purduerov/X12-Solenoid-Board/solenoid.step

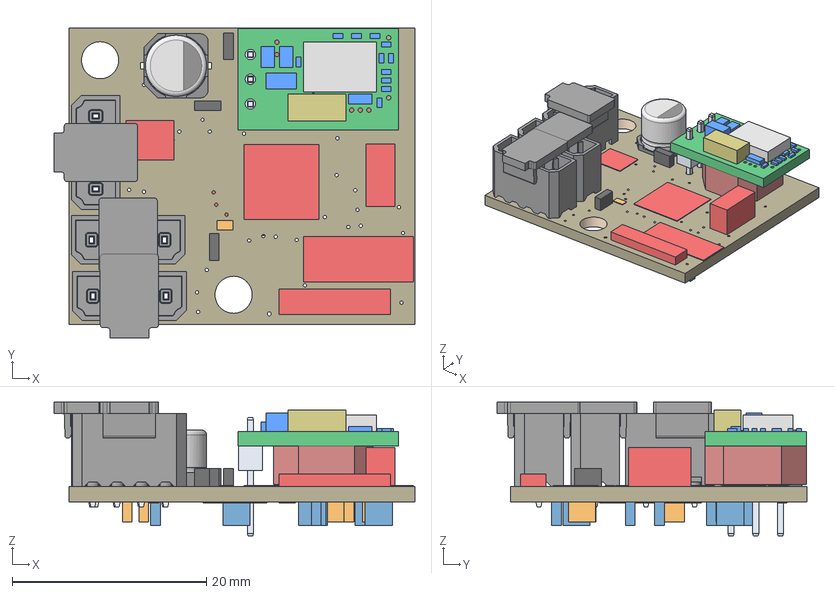
[picture p1: CAD file, 2020-10-26]
solenoid.step
37.1 x 31.9 x 13.8 mm
Board
20pF x 7
0.1uF
LED-0603 x 3
FE05-1
STM32F042K6T6
ECS-80-S-4X
MURATA-DC-DC
ULN2003V12
DISCRETECOMPONENTS_SWITCH
6-32-HOLE x 2
ptsm_0.5_pad x 3
ptsm_0.5-4-hv-2.5-thr x 3
TCAN337D
WSIZE CODE D-001
WSIZE CODE D-002
WSIZE CODE D-003 x 2
