purduerov/X12-Solenoid-Board/solenoid.brd

## EAGLE design solenoid.brd (2020-10-26)

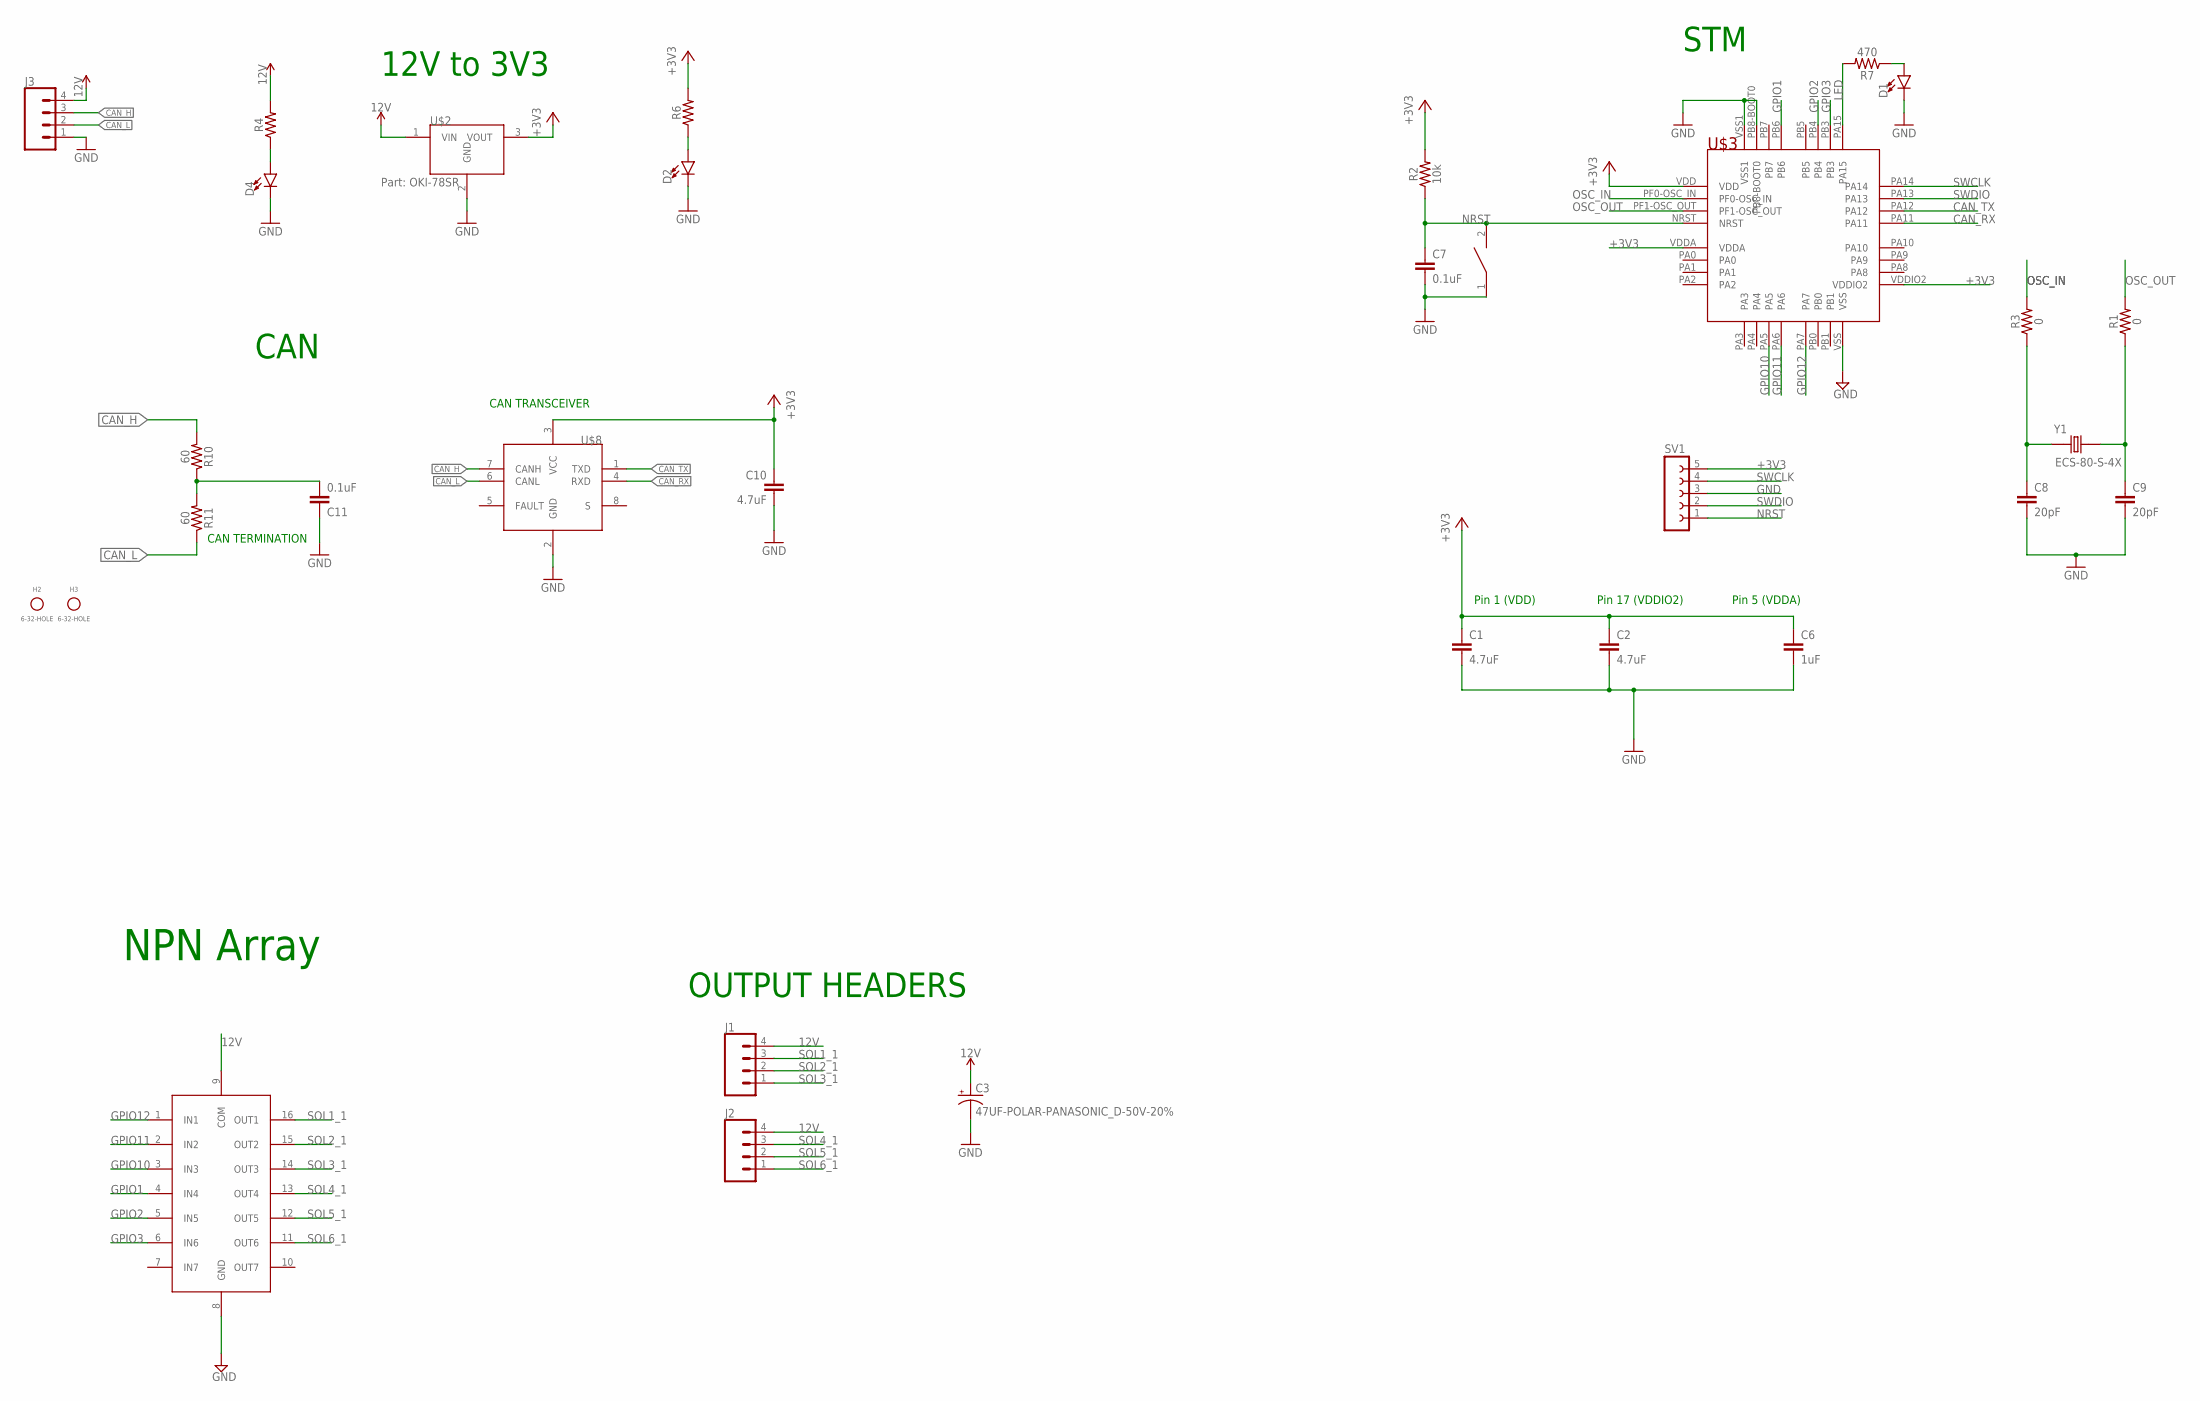
[picture p2: schematic solenoid.sch]

Parts:
C1, C2, C10: 4.7uF; 0603
C3: 47UF-POLAR-PANASONIC_D-50V-20%; PANASONIC_D
C6: 1uF; 0603
C7, C11: 0.1uF; 0603
C8, C9: 20pF; 0603
D1, D2, D4: LED0603; LED-0603
H2, H3: 6-32-HOLE
J1, J2, J3: PXC-PTSM-04-V-1778573
R1, R3: 0; 0603
R2: 10k; 0603
R4, R6: 0603
R7: 470; 0603
R10, R11: 60; 0603
SV1: FE05-1
U1: ULN2003V12
U$1: DISCRETECOMPONENTS_SWITCH; DISCRETECOMPONENTS_SW_2512
U$2: MURATA-DC-DC
U$3: STM32F042K6T6
U$8: TCAN337D; SOIC-8
Y1: ECS-80-S-4X; XTAL_ECS-80-S-4X

Connections:
12V: C3.+, J1.4, J2.4, J3.4, R4.2, U1.9 (COM), U$2.1 (VIN)
+3V3: C1.1, C2.1, C6.1, C10.1, R2.2, R6.2, SV1.5, U$2.3 (VOUT), U$3.VDD, U$3.VDDA, U$3.VDDIO2, U$8.3 (VCC)
CAN_H: J3.3, R10.2, U$8.7 (CANH)
CAN_L: J3.2, R11.1, U$8.6 (CANL)
CAN_RX: U$3.PA11, U$8.4 (RXD)
CAN_TX: U$3.PA12, U$8.1 (TXD)
GND: C1.2, C2.2, C3.-, C6.2, C7.2, C8.2, C9.2, C10.2, C11.1, D1.C, D2.C, D4.C, J3.1, SV1.3, U1.8 (GND), U$1.1, U$2.2 (GND), U$3.PB8-BOOT0, U$3.VSS, U$3.VSS1, U$8.2 (GND)
GPIO1: U1.4 (IN4), U$3.PB6
GPIO2: U1.5 (IN5), U$3.PB4
GPIO3: U1.6 (IN6), U$3.PB3
GPIO10: U1.3 (IN3), U$3.PA5
GPIO11: U1.2 (IN2), U$3.PA6
GPIO12: U1.1 (IN1), U$3.PA7
LED: R7.2, U$3.PA15
unnamed: C9.1, R1.1, Y1.2
unnamed: C8.1, R3.1, Y1.1
unnamed: C11.2, R10.1, R11.2
unnamed: D1.A, R7.1
unnamed: D4.A, R4.1
unnamed: D2.A, R6.1
NRST: C7.1, R2.1, SV1.1, U$1.2, U$3.NRST
OSC_IN: R3.2, U$3.PF0-OSC_IN
OSC_OUT: R1.2, U$3.PF1-OSC_OUT
SOL1_1: J1.3, U1.16 (OUT1)
SOL2_1: J1.2, U1.15 (OUT2)
SOL3_1: J1.1, U1.14 (OUT3)
SOL4_1: J2.3, U1.13 (OUT4)
SOL5_1: J2.2, U1.12 (OUT5)
SOL6_1: J2.1, U1.11 (OUT6)
SWCLK: SV1.4, U$3.PA14
SWDIO: SV1.2, U$3.PA13

Notes on the sheet:
CAN
STM
OUTPUT HEADERS
12V to 3V3
CAN TRANSCEIVER
CAN TERMINATION
Pin 1 (VDD)
Pin 17 (VDDIO2)
Pin 5 (VDDA)
NPN Array

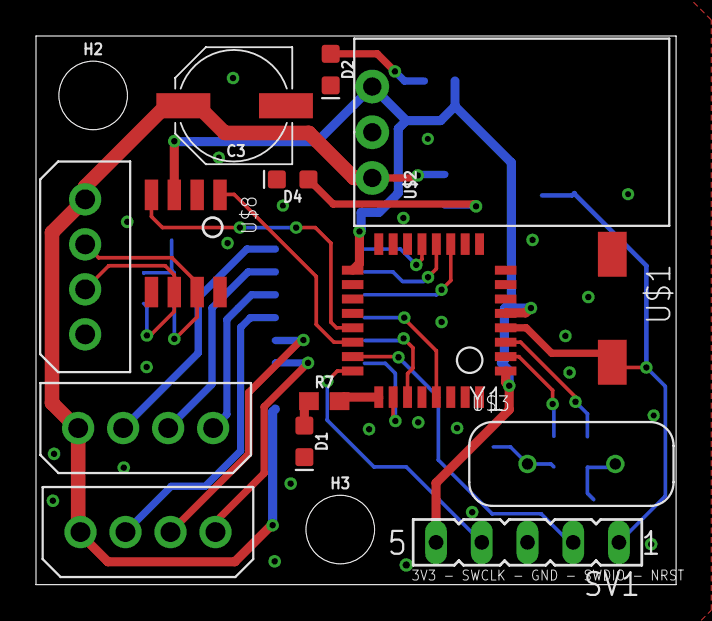
[picture p3: board solenoid.brd from above]

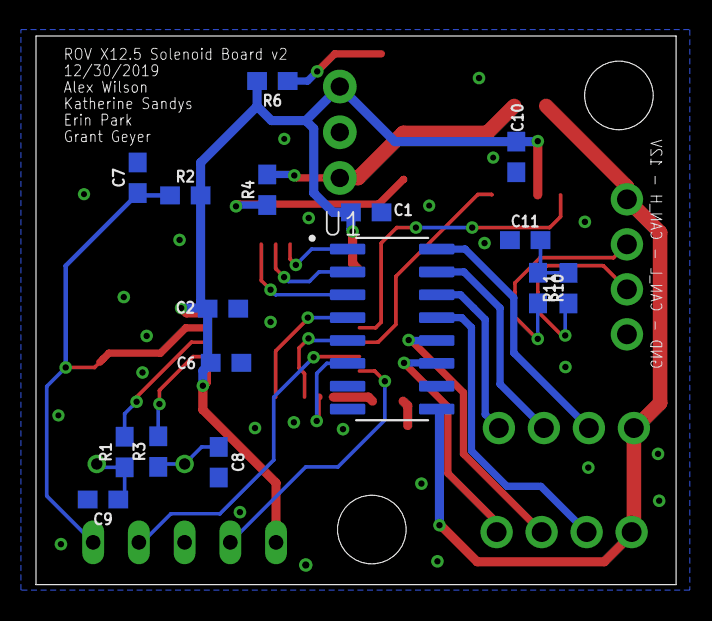
[picture p4: board solenoid.brd from below]

Board: 2 copper layers, 35.6 x 30.5 mm, 32 parts (16 on the bottom side), 31 nets.
