purduerov/X12-Solenoid-Board/(commit log)

2019-10-09 Created new schematic from last year's
    Created the new schematic based off of components from last year.
    Major components are the CAN and STM block, GPIO mosfets, and 12V to 3V3 converter.
    [solenoid.sch]
2019-10-16 Switched mosfets out for H-bridges
    Deleted the solenoid mosfets and replaced them with 4 H-bridge parts
    [solenoid.sch]
2019-10-24 Created the board and placed everything. Started routing
    [solenoid.brd, solenoid.sch]
2019-10-30 Newly sized board w/ schematic changes
    This is the first attempt at routing the 1.2" by 1.4" solenoid board with a removed h-bridge and with some questions as to some airwires
    [solenoid.brd, solenoid.sch]
2019-10-30 last version of this board
    abandon all hope of this first draft. It passed DRC for default but not the DRC for ECE Senior Design have to scrap this idea :(
    [solenoid.brd]
2019-11-07 Clearance issues fixed
    [solenoid.brd, solenoid.sch]
2019-11-13 small updates
    finished making the wire impedances the same for oscillator and programming header, also made minor wire movements
    [solenoid.brd]
2019-11-16 added standoff, moved around some header
    [solenoid.brd, solenoid.sch]
2019-11-16 added a dxf file to the branch
    [solenoid.dxf]
2019-12-19 Solenoid v1
    Final changes to capacitor and few small changes
    [solenoid.brd, solenoid.sch]
2019-12-19 put on bmp
    [solenoid.brd]
2019-12-19 added some silk screen information about board
    [solenoid.brd]
2019-12-31 Fixed Labeling
    [solenoid.brd]
2020-09-10 Make the schematic and board consistent Revert "Fixed Labeling"
    This reverts commit 7386091f4d909d3dfabd7faa3d4cd36d2ed047bf.
    [solenoid.brd]
2020-09-10 Update 12->3.3 converter, make extra layers inactive, fix names
    [solenoid.brd, solenoid.sch]
2020-09-10 buck converter cad
    [solenoid.step]
2020-09-12 deleted h bridges - broken
    [solenoid.brd, solenoid.sch]
2020-09-12 potentially finished schematic
    [solenoid.brd, solenoid.sch]
2020-09-19 solenoid work
    [solenoid.brd, solenoid.dxf, solenoid.sch]
2020-09-30 worked on some trace things and wiring
    [solenoid.brd]
2020-09-30 next I make solenoid thingies 20 width
    [solenoid.brd, solenoid.sch]
2020-10-03 maybe ready ?
    [solenoid.brd]
2020-10-03 better can in progress
    [solenoid.brd]
2020-10-07 cans are equal length now yay and no overlap with 12v
    [solenoid.brd]
2020-10-07 good board 10/10
    [solenoid.brd]
2020-10-07 stud edit
    [solenoid.brd]
2020-10-26 new connectors. another hole. v2
    [solenoid.brd, solenoid.sch, solenoid.step]
2020-10-26 final touch-ups
    [solenoid.brd, solenoid.sch, solenoid.step]
